Cyrprian/ProjektZespo-owy-Kod-Cad/Robot/zdjecie_4.jpg

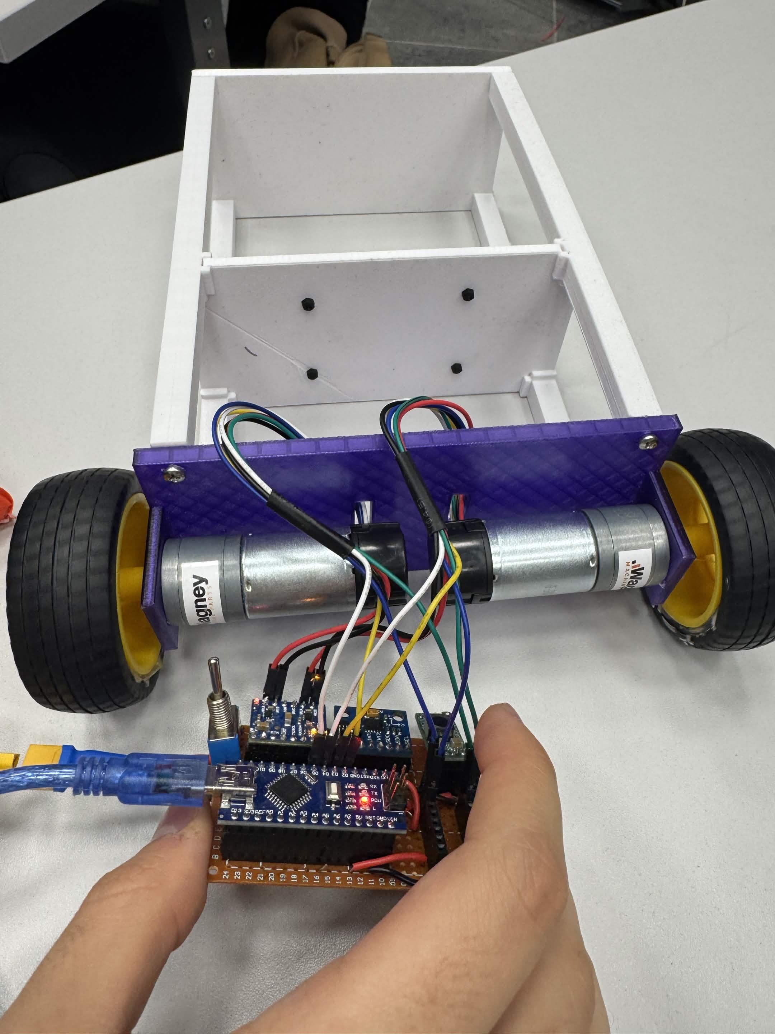
Robot/zdjecie_4.jpg
