Cyrprian/ProjektZespo-owy-Kod-Cad/Robot/zdjecie_3.jpg

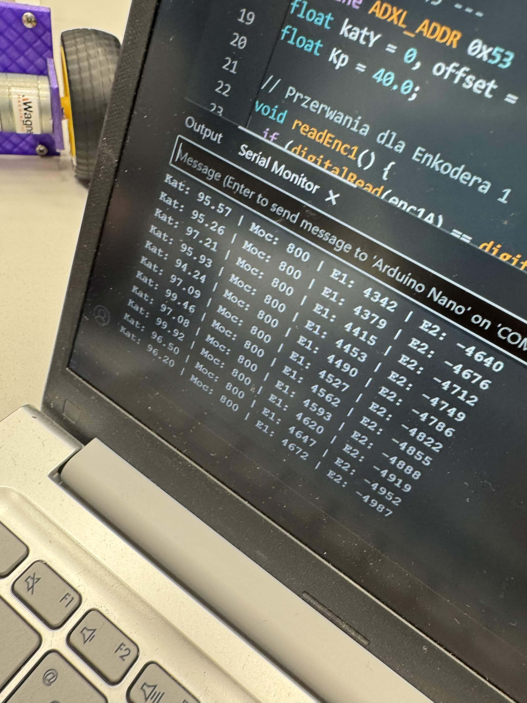
Robot/zdjecie_3.jpg
