Cyrprian/ProjektZespo-owy-Kod-Cad/Robot/zdjecie_1.jpg

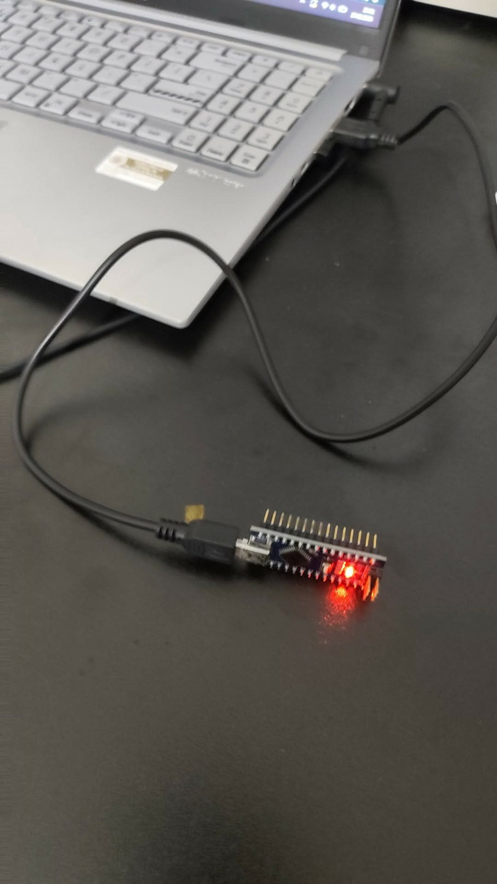
Robot/zdjecie_1.jpg
