Cyrprian/ProjektZespo-owy-Kod-Cad/Robot/zdjecie_2.jpg

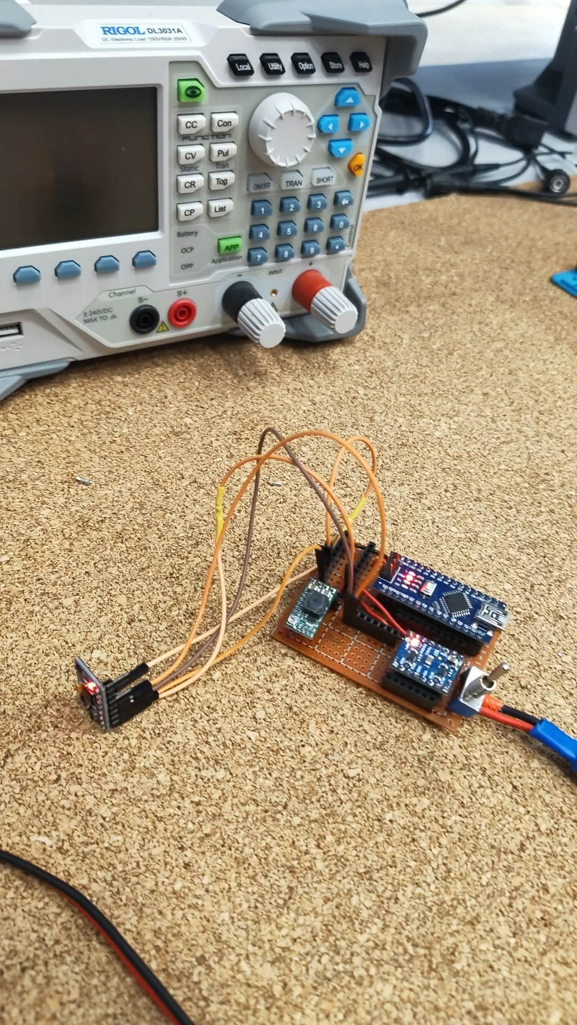
Robot/zdjecie_2.jpg
