Cyrprian/ProjektZespo-owy-Kod-Cad/Cad-KiCad/CAD/RobotBalansujący.SLDASM

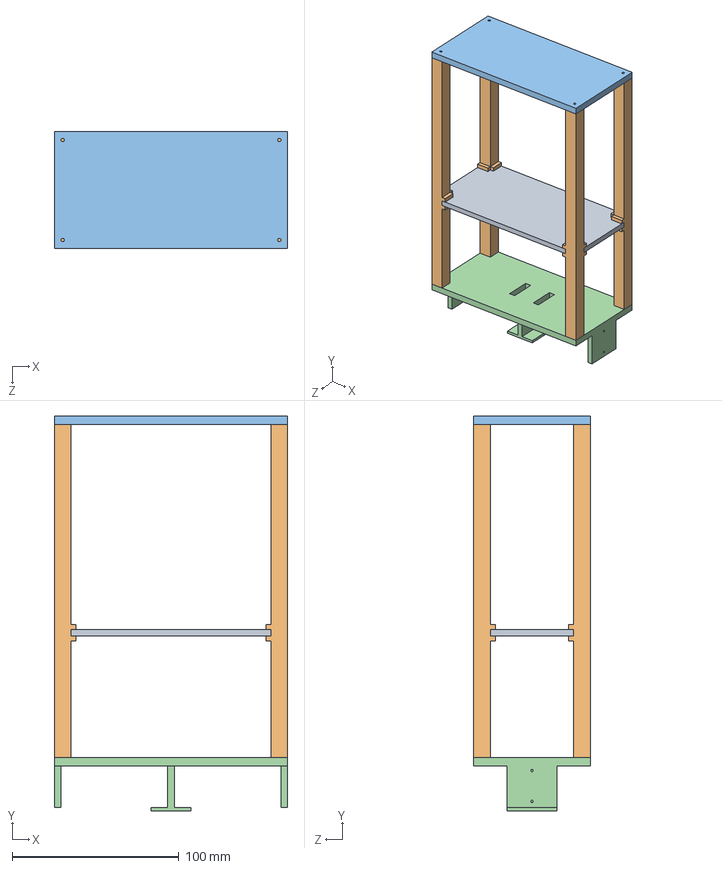
[picture p5: CAD file, 2026-06-11]
Cad-KiCad/CAD/RobotBalansujący.SLDASM
140.0 x 237.0 x 70.0 mm
podstwka
góra
kije x 4
pólka
