Cyrprian/ProjektZespo-owy-Kod-Cad/Cad-KiCad/CAD/góra.SLDPRT

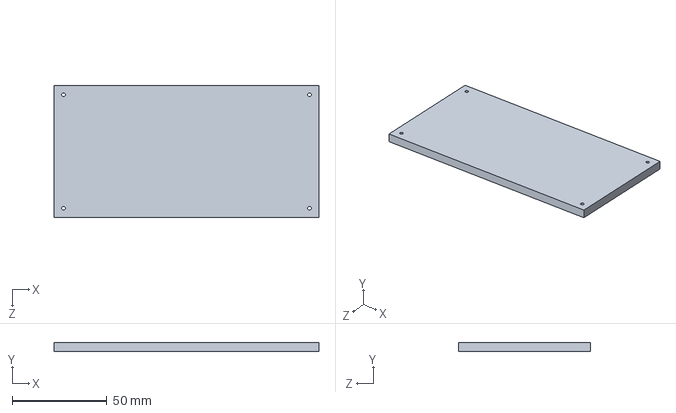
[picture p6: CAD file, 2026-06-11]
Cad-KiCad/CAD/góra.SLDPRT
140.0 x 5.00 x 70.0 mm
