Cyrprian/ProjektZespo-owy-Kod-Cad/Cad-KiCad/CAD/kije.SLDPRT

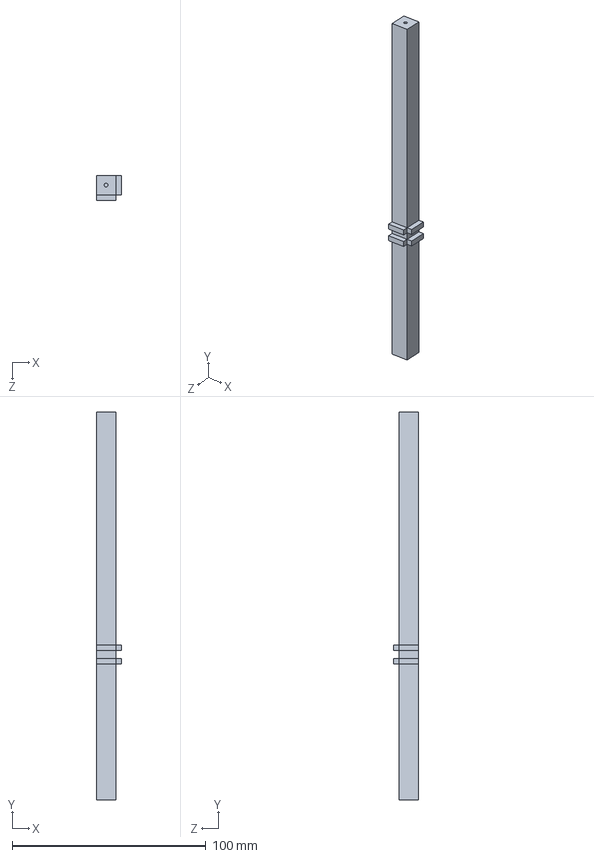
[picture p7: CAD file, 2026-06-11]
Cad-KiCad/CAD/kije.SLDPRT
13.0 x 200.0 x 13.0 mm
