Cyrprian/ProjektZespo-owy-Kod-Cad/Cad-KiCad/CAD/podstwka.SLDPRT

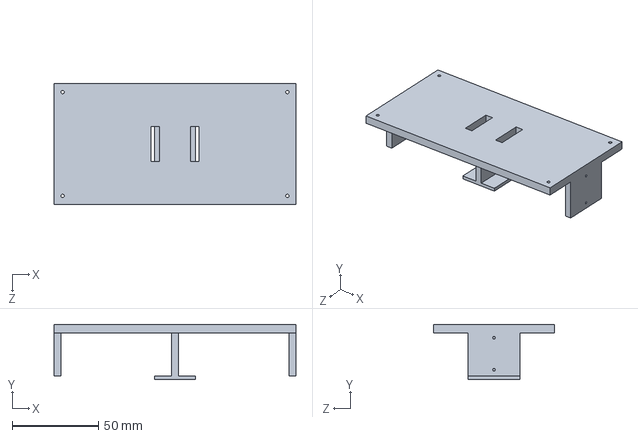
[picture p8: CAD file, 2026-06-11]
Cad-KiCad/CAD/podstwka.SLDPRT
140.0 x 32.0 x 70.0 mm
