Cyrprian/ProjektZespo-owy-Kod-Cad/Cad-KiCad/CAD/pólka.SLDPRT

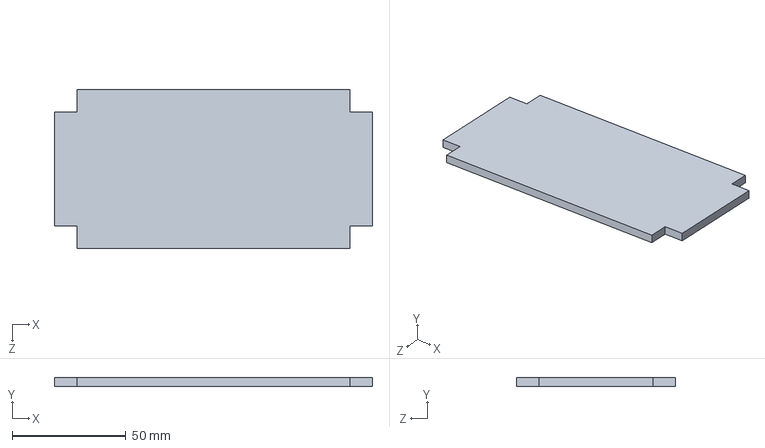
[picture p9: CAD file, 2026-06-11]
Cad-KiCad/CAD/pólka.SLDPRT
140.0 x 4.00 x 70.0 mm
